Naktrem/DigitalizedEnigmaMachineReconstruction/README.md

# DigitalizedEnigmaMachineReconstruction
This is a simple project to replicate the original "Enigma Machine" by using Arduino. Main objective in this project is to create a machine that is easy to replicate and can be used to teach the basic concepts of cryptology. Details, resources and references can be found in the pdf.  

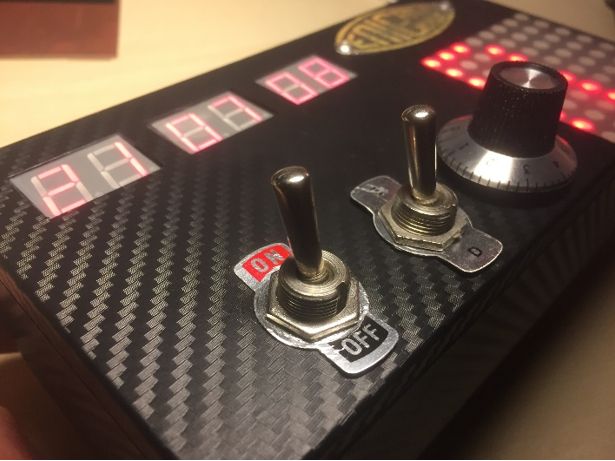
[picture p1: E1.PNG]
